bhaveshbanshiwal/Snake_SURGE/3d_parts/3D_motion_parts/snake_head.STEP

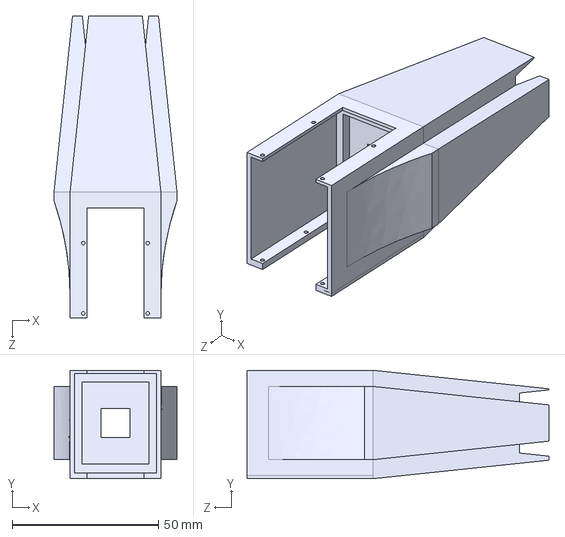
[picture p1: CAD file, 2026-11-07]
3d_parts/3D_motion_parts/snake_head.STEP
42.0 x 37.0 x 103.0 mm
