bhaveshbanshiwal/Snake_SURGE/3d_parts/plate chains/esp_transmittor_case_shell.STEP

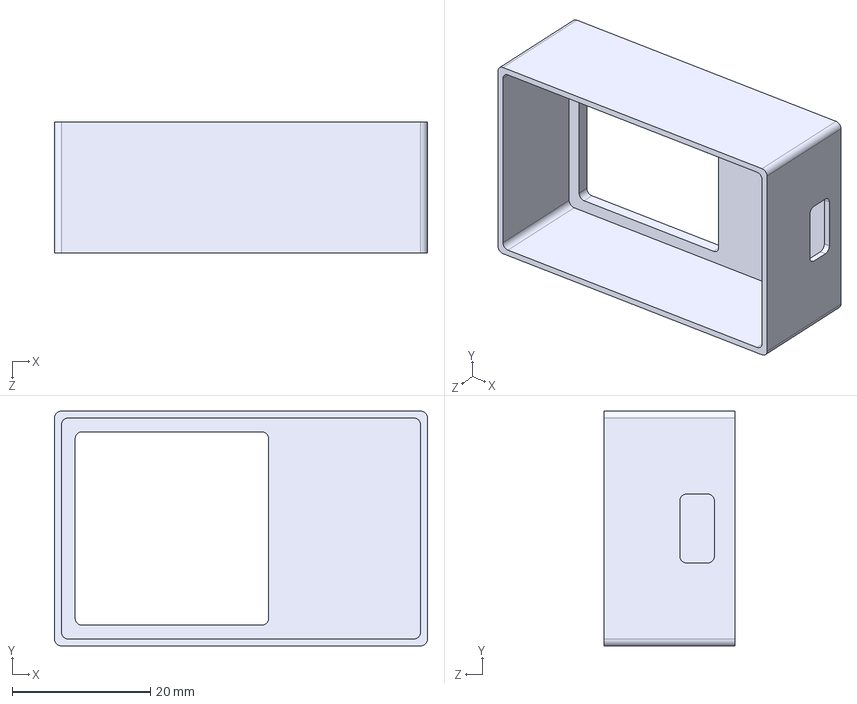
[picture p2: CAD file, 2026-09-26]
3d_parts/plate chains/esp_transmittor_case_shell.STEP
54.0 x 34.0 x 19.0 mm
