bhaveshbanshiwal/Snake_SURGE/3d_parts/3D_motion_parts/battery_middle.STEP

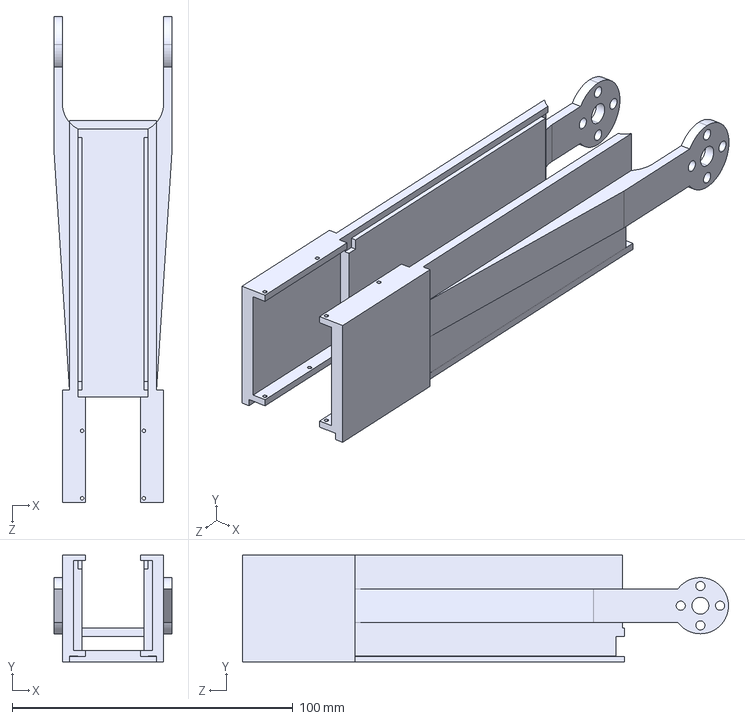
[picture p4: CAD file, 2026-10-31]
3d_parts/3D_motion_parts/battery_middle.STEP
42.0 x 38.0 x 173.0 mm
