bhaveshbanshiwal/Snake_SURGE/3d_parts/plate chains/up_plate_non_power.STEP

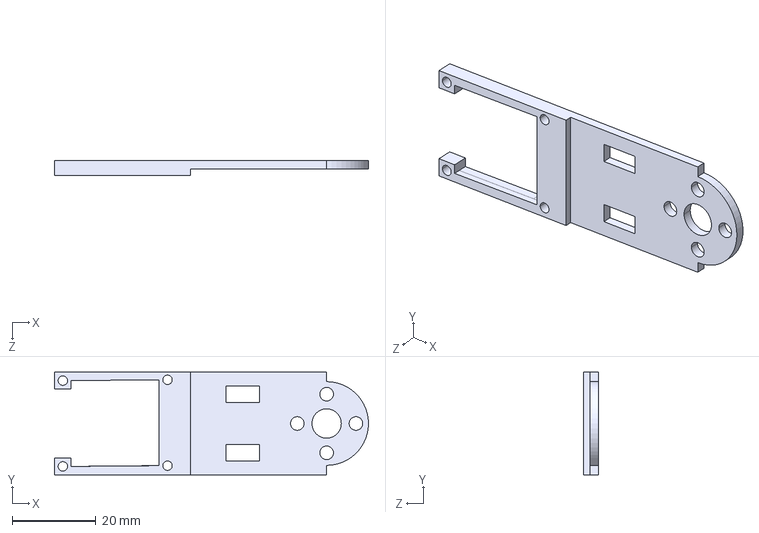
[picture p5: CAD file, 2026-09-26]
3d_parts/plate chains/up_plate_non_power.STEP
75.0 x 24.5 x 3.50 mm
