bhaveshbanshiwal/Snake_SURGE/3d_parts/snake_segment.step

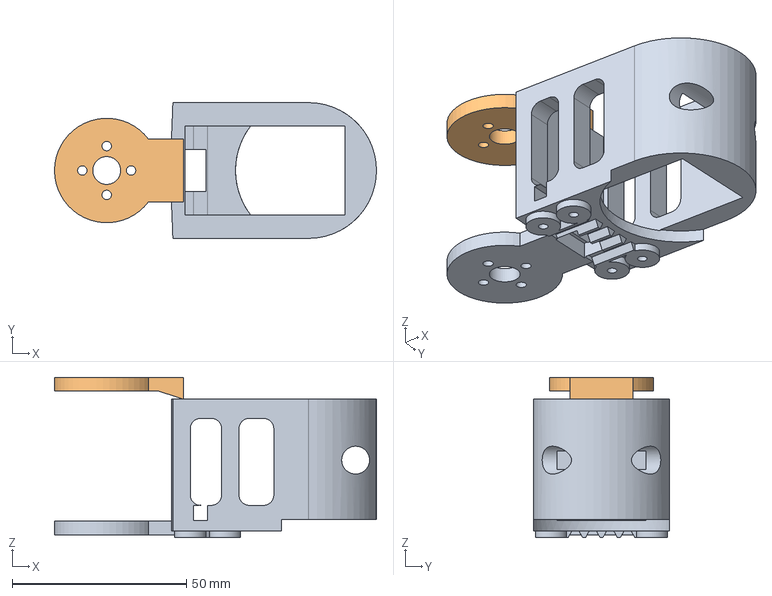
[picture p6: CAD file, 2026-09-23]
3d_parts/snake_segment.step
92.5 x 39.0 x 46.1 mm
