bhaveshbanshiwal/Snake_SURGE/3d_parts/3D_motion_parts/alternate_connector.STEP

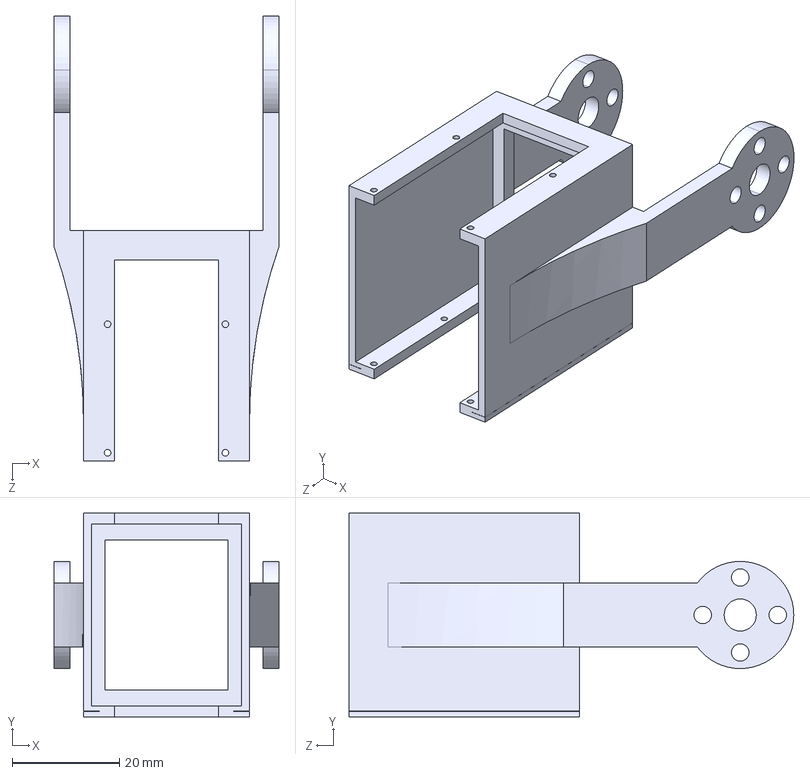
[picture p7: CAD file, 2026-10-31]
3d_parts/3D_motion_parts/alternate_connector.STEP
42.0 x 38.0 x 83.0 mm
