bhaveshbanshiwal/Snake_SURGE/3d_parts/plate chains/esp_transmittor_case.STEP

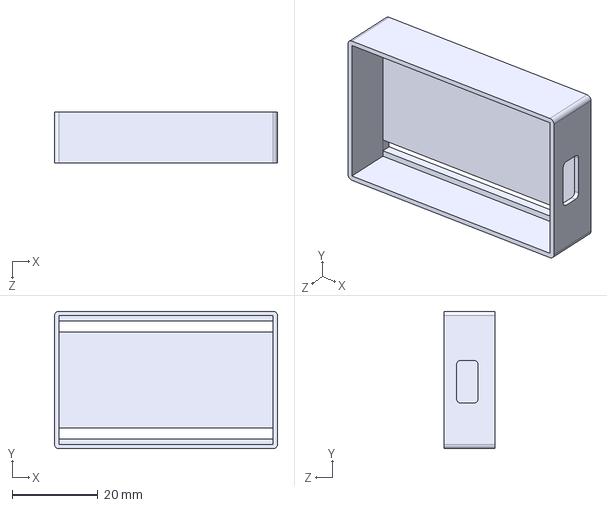
[picture p8: CAD file, 2026-09-26]
3d_parts/plate chains/esp_transmittor_case.STEP
52.0 x 32.0 x 12.0 mm
