bhaveshbanshiwal/Snake_SURGE/3d_parts/plate chains/tail_esp32_waveshare_holder.STEP

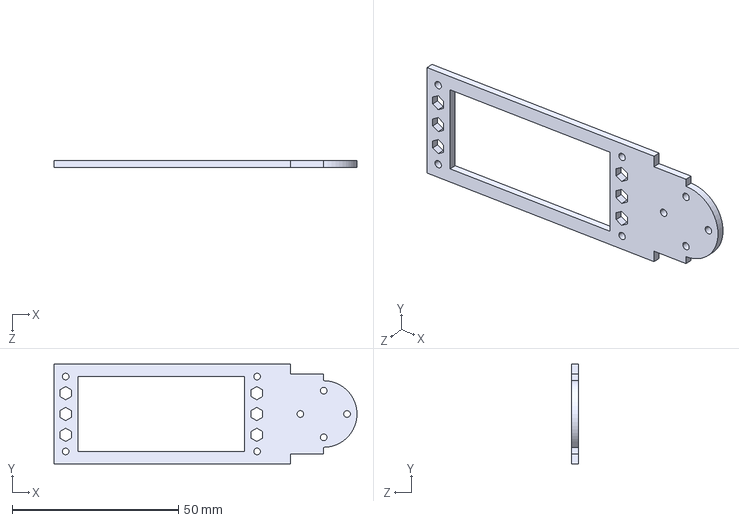
[picture p9: CAD file, 2026-09-25]
3d_parts/plate chains/tail_esp32_waveshare_holder.STEP
91.0 x 30.0 x 2.00 mm
