bhaveshbanshiwal/Snake_SURGE/3d_parts/plate chains/tail_column.STEP

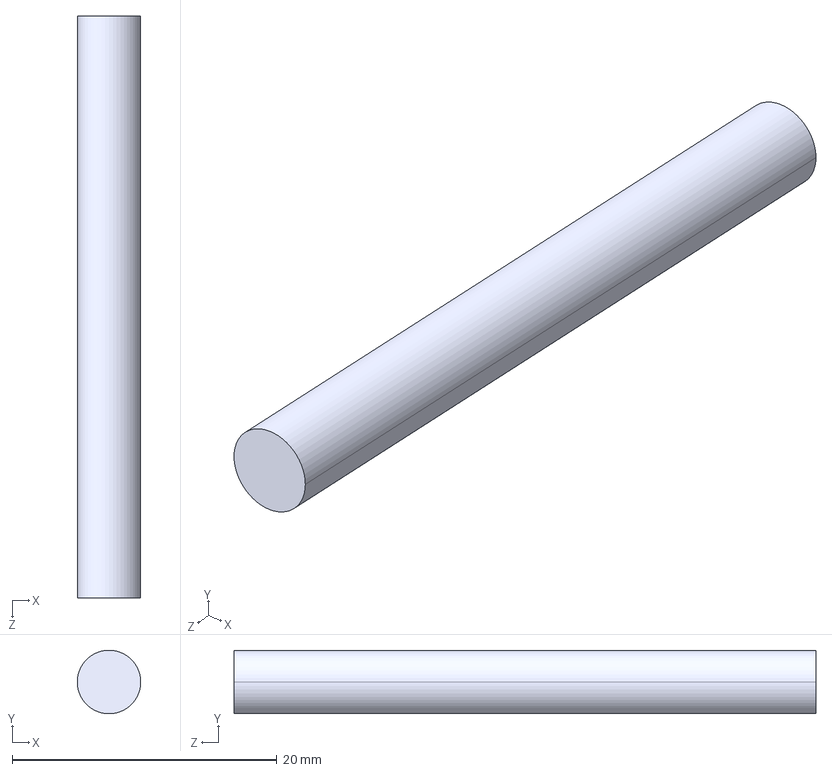
[picture p10: CAD file, 2026-09-25]
3d_parts/plate chains/tail_column.STEP
4.80 x 4.80 x 44.0 mm
