bhaveshbanshiwal/Snake_SURGE/3d_parts/plate chains/waveshare_esp32_holder.STEP

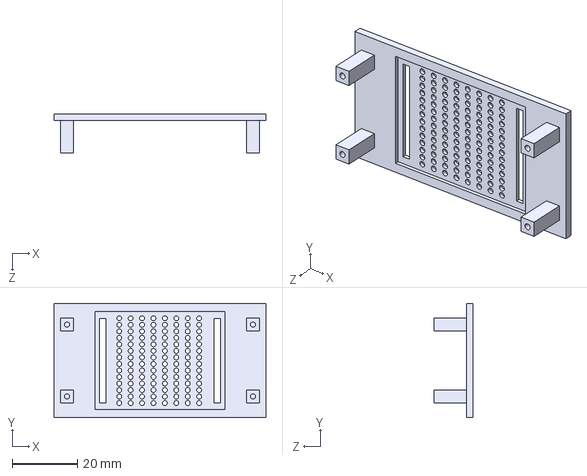
[picture p11: CAD file, 2026-09-24]
3d_parts/plate chains/waveshare_esp32_holder.STEP
65.0 x 35.0 x 12.0 mm
