bhaveshbanshiwal/Snake_SURGE/(list of files, cad)

Other CAD files:
3d_parts/plate chains/down_plate_power.STEP
3d_parts/3D_motion_parts/alternate_connector.SLDPRT
3d_parts/3D_motion_parts/battery_middle.SLDPRT
3d_parts/3D_motion_parts/snake_head.SLDPRT
3d_parts/plate chains/down_plate_power.SLDPRT
3d_parts/plate chains/esp_transmittor_case.SLDPRT
3d_parts/plate chains/esp_transmittor_case_shell.SLDPRT
3d_parts/plate chains/tail_column.SLDPRT
3d_parts/plate chains/tail_esp32_waveshare_holder.SLDPRT
3d_parts/plate chains/up_plate_non_power.SLDPRT
3d_parts/plate chains/waveshare_esp32_holder.SLDPRT
3d_parts/snake_segment.3mf
