bhaveshbanshiwal/Snake_SURGE/adxl_history.txt

commit 35a82d757dcc97c1be2922480adf8482c64d93d7
Author: Bhavesh Banshiwal <97866170+bhaveshbanshiwal@users.noreply.github.com>
Date:   Thu Sep 24 18:27:41 2026 +0530

    new_changes removed the old faulty esp32_st73215.ino file

diff --git a/src/esp32_st3215/esp32_st3215.ino b/src/esp32_st3215/esp32_st3215.ino
index 7fc1bd0..dd99c4a 100644
--- a/src/esp32_st3215/esp32_st3215.ino
+++ b/src/esp32_st3215/esp32_st3215.ino
@@ -1,208 +1,177 @@
+#include "soc/rtc_cntl_reg.h"
+#include "soc/soc.h"
+#include <Adafruit_GFX.h>
+#include <Adafruit_SSD1306.h>
+#include <SCServo.h>
 #include <WiFi.h>
-#include <WebServer.h>
 #include <Wire.h>
-#include <DHT.h>
-#include <Adafruit_Sensor.h>
-#include <Adafruit_BMP280.h>
-#include <Adafruit_ADXL345_U.h>
+#include <esp_mac.h>
+#include <esp_now.h>
 #include <esp_wifi.h>
 
-// --- HOTSPOT SETTINGS ---
-const char* ssid = "NF-07-STATS";
-const char* password = "zaybxc09@";
-
-WebServer server(80); 
-
-// --- PIN MAPPING ---
-const int trigPin = 32; 
-const int echoPin = 34; 
-#define DHTPIN 22     
-#define DHTTYPE DHT11
-DHT dht(DHTPIN, DHTTYPE);
-
-const int I2C_SDA = 21;
-const int I2C_SCL = 19;
-
-Adafruit_BMP280 bmp; 
-Adafruit_ADXL345_Unified accel = Adafruit_ADXL345_Unified(12345);
-
-// --- GLOBAL VARIABLES ---
-float dhtTemp = 0.0, dhtHum = 0.0;
-float bmpTemp = 25.0, bmpPressure = 0.0, bmpAltitude = 0.0;
-float currentDistance = 0.0;
-float accelX = 0.0, accelY = 0.0, accelZ = 0.0;
-
-unsigned long lastFastRead = 0;
-unsigned long lastSlowRead = 0;
-
-// --- PRECISION ULTRASONIC READ ---
-float getAccurateDistance(float tempC) {
-  float soundSpeed_cm_us = (331.3 + 0.606 * tempC) / 10000.0;
-  float samples[3];
-  int validCount = 0;
-
-  for (int i = 0; i < 3; i++) {
-    digitalWrite(trigPin, LOW);
-    delayMicroseconds(2);
-    digitalWrite(trigPin, HIGH);
-    delayMicroseconds(10);
-    digitalWrite(trigPin, LOW);
-    
-    long duration = pulseIn(echoPin, HIGH, 15000); // Tight 15ms timeout to prevent lag
-    if (duration > 0) samples[validCount++] = (duration * soundSpeed_cm_us) / 2.0;
-    delayMicroseconds(500); 
+volatile char wirelessBuffer[250];
+volatile bool hasWirelessCmd = false;
+enum ConnectionState {
+  STATE_INIT,
+  STATE_DISCONNECTED,
+  STATE_USB,
+  STATE_ESPNOW,
+  STATE_BOTH
+};
+ConnectionState currentState = STATE_INIT;
+unsigned long lastUsbTime = 0;
+unsigned long lastEspNowTime = 0;
+unsigned long holdMessageUntil = 0;
+void OnDataRecv(const esp_now_recv_info *info, const uint8_t *incomingData,
+                int len) {
+  if (len < 250) {
+    memcpy((void *)wirelessBuffer, incomingData, len);
+    wirelessBuffer[len] = '\0';
+    hasWirelessCmd = true;
   }
-
-  if (validCount == 0) return 0.0;
-  if (validCount == 1) return samples[0];
-  if (validCount == 2) return (samples[0] + samples[1]) / 2.0;
-
-  if (samples[0] > samples[1]) { float t = samples[0]; samples[0] = samples[1]; samples[1] = t; }
-  if (samples[1] > samples[2]) { float t = samples[1]; samples[1] = samples[2]; samples[2] = t; }
-  if (samples[0] > samples[1]) { float t = samples[0]; samples[0] = samples[1]; samples[1] = t; }
-
-  return samples[1]; 
 }
-
-// --- FRONTEND UI (Chat Removed, 100ms Refresh) ---
-const char INDEX_HTML[] PROGMEM = R"rawliteral(
-<!DOCTYPE html>
-<html>
-<head>
-  <meta name="viewport" content="width=device-width, initial-scale=1">
-  <title>Precision Scale & Sentry</title>
-  <style>
-    body { font-family: Arial, sans-serif; text-align: center; background-color: #121212; color: #ffffff; margin: 0; padding: 20px; }
-    .card { background: #1e1e1e; padding: 20px; margin: 0 auto 20px auto; width: 100%; max-width: 450px; border-radius: 12px; box-shadow: 0 8px 16px rgba(0,0,0,0.6); }
-    h1 { color: #00ffcc; font-size: 22px; margin-bottom: 20px; text-transform: uppercase; letter-spacing: 1px; }
-    h2 { color: #fff; font-size: 15px; margin-bottom: 10px; border-bottom: 1px solid #333; padding-bottom: 5px; text-align: left; text-transform: uppercase; color: #888; margin-top: 25px; }
-    .row { display: flex; justify-content: space-between; align-items: center; padding: 12px 0; border-bottom: 1px solid #2a2a2a; }
-    .row:last-child { border-bottom: none; }
-    .label-group { text-align: left; }
-    .label { font-size: 15px; color: #dddddd; }
-    .sensor { font-size: 11px; color: #777777; margin-left: 5px; }
-    .value { font-size: 18px; font-weight: bold; color: #00ffcc; }
-    .highlight .value { color: #ffd32a; font-size: 24px; }
-  </style>
-</head>
-<body>
-  <div class="card">
-    <h1>Precision Sentry Node</h1>
-    
-    <h2>Live High-Speed Data (100ms)</h2>
-    <div class="row highlight"><div class="label-group"><span class="label">Compensated Distance</span><span class="sensor">(HC-SR04)</span></div><div class="value"><span id="dist">--</span> cm</div></div>
-    <div class="row"><div class="label-group"><span class="label">X-Axis Tilt</span><span class="sensor">(ADXL345)</span></div><div class="value"><span id="tiltX">--</span> g</div></div>
-    <div class="row"><div class="label-group"><span class="label">Y-Axis Tilt</span><span class="sensor">(ADXL345)</span></div><div class="value"><span id="tiltY">--</span> g</div></div>
-    <div class="row"><div class="label-group"><span class="label">Z-Axis Gravity</span><span class="sensor">(ADXL345)</span></div><div class="value"><span id="tiltZ">--</span> g</div></div>
-    
-    <div class="row"><div class="label-group"><span class="label">Micro-Temp</span><span class="sensor">(BMP280)</span></div><div class="value"><span id="bmpT">--</span> &deg;C</div></div>
-    <div class="row"><div class="label-group"><span class="label">Pressure</span><span class="sensor">(BMP280)</span></div><div class="value"><span id="bmpP">--</span> hPa</div></div>
-    <div class="row"><div class="label-group"><span class="label">Altitude</span><span class="sensor">(BMP280)</span></div><div class="value"><span id="bmpA">--</span> m</div></div>
-
-    <h2>Ambient Climate (2000ms)</h2>
-    <div class="row"><div class="label-group"><span class="label">Room Temp</span><span class="sensor">(DHT11)</span></div><div class="value"><span id="dhtT">--</span> &deg;C</div></div>
-    <div class="row"><div class="label-group"><span class="label">Humidity</span><span class="sensor">(DHT11)</span></div><div class="value"><span id="dhtH">--</span> %</div></div>
-  </div>
-
-  <script>
-    // Max-Speed AJAX fetching at 100ms (10 FPS)
-    setInterval(function() {
-      fetch('/data')
-        .then(response => response.json())
-        .then(data => {
-          document.getElementById('dist').innerText = data.dist.toFixed(1);
-          document.getElementById('tiltX').innerText = data.tiltX.toFixed(2);
-          document.getElementById('tiltY').innerText = data.tiltY.toFixed(2);
-          document.getElementById('tiltZ').innerText = data.tiltZ.toFixed(2);
-          
-          document.getElementById('bmpT').innerText = data.bmpT.toFixed(2); // Higher precision for fast updates
-          document.getElementById('bmpP').innerText = data.bmpP.toFixed(1);
-          document.getElementById('bmpA').innerText = data.bmpA.toFixed(0);
-
-          document.getElementById('dhtT').innerText = data.dhtT.toFixed(1);
-          document.getElementById('dhtH').innerText = data.dhtH.toFixed(0);
-        }).catch(err => {});
-    }, 100); 
-  </script>
-</body>
-</html>
-)rawliteral";
-
-void handleRoot() { server.send(200, "text/html", INDEX_HTML); }
-
-void handleData() {
-  String json = "{";
-  json += "\"dist\":" + String(currentDistance, 1) + ",";
-  json += "\"tiltX\":" + String(accelX) + ",";
-  json += "\"tiltY\":" + String(accelY) + ",";
-  json += "\"tiltZ\":" + String(accelZ) + ",";
-  json += "\"bmpT\":" + String(bmpTemp) + ",";
-  json += "\"dhtT\":" + String(dhtTemp) + ",";
-  json += "\"dhtH\":" + String(dhtHum) + ",";
-  json += "\"bmpP\":" + String(bmpPressure) + ",";
-  json += "\"bmpA\":" + String(bmpAltitude);
-  json += "}";
-  server.send(200, "application/json", json);
+#define SCREEN_WIDTH 128
+#define SCREEN_HEIGHT 32
+#define OLED_RESET -1
+Adafruit_SSD1306 display(SCREEN_WIDTH, SCREEN_HEIGHT, &Wire, OLED_RESET);
+void updateDisplay(ConnectionState newState) {
+  if (currentState == newState)
+    return;
+  if (millis() < holdMessageUntil && newState == STATE_DISCONNECTED)
+    return;
+  currentState = newState;
+  display.clearDisplay();
+  display.setTextSize(1);
+  display.setTextColor(SSD1306_WHITE);
+  display.setCursor(0, 0);
+  display.println("Snake SURGE");
+  if (newState == STATE_DISCONNECTED) {
+    display.println("Status: Waiting...");
+    uint8_t mac[6];
+    esp_read_mac(mac, ESP_MAC_WIFI_STA);
+    char macStr[18];
+    snprintf(macStr, sizeof(macStr), "%02X:%02X:%02X:%02X:%02X:%02X", mac[0],
+             mac[1], mac[2], mac[3], mac[4], mac[5]);
+    display.println(macStr);
+  } else if (newState == STATE_USB) {
+    display.println("Status: USB Active");
+  } else if (newState == STATE_ESPNOW) {
+    display.println("Status: Wireless RX");
+  } else if (newState == STATE_BOTH) {
+    display.println("Status: USB+Wireless");
+  }
+  display.display();
 }
-
+SMS_STS st;
+#define S_RXD 18
+#define S_TXD 19
 void setup() {
-  setCpuFrequencyMhz(240); // Max Processor Speed
-
-  pinMode(trigPin, OUTPUT);
-  pinMode(echoPin, INPUT);
-  dht.begin();
-  
-  Wire.begin(I2C_SDA, I2C_SCL); 
-  Wire.setClock(400000); // I2C Fast Mode
-  
-  if (bmp.begin(0x76) || bmp.begin(0x77)) {
-    // Drop standby time to 63ms to allow the BMP280 to update faster than our 100ms loop
-    bmp.setSampling(Adafruit_BMP280::MODE_NORMAL, Adafruit_BMP280::SAMPLING_X2, Adafruit_BMP280::SAMPLING_X16, Adafruit_BMP280::FILTER_X16, Adafruit_BMP280::STANDBY_MS_63);
+  WRITE_PERI_REG(RTC_CNTL_BROWN_OUT_REG, 0);
+  Serial.begin(115200);
+  Serial1.begin(1000000, SERIAL_8N1, S_RXD, S_TXD);
+  st.pSerial = &Serial1;
+  Wire.begin(21, 22);
+  display.begin(SSD1306_SWITCHCAPVCC, 0x3C);
+
+  // SAFETY CAPPING: Limit max torque to 20% (200/1000) for all servos (ID 254)
+  // This physically limits the max current draw so 10 motors won't overload
+  // your supply
+  st.writeWord(254, 48, 200);
+
+  WiFi.mode(WIFI_STA);
+  WiFi.disconnect();
+  esp_wifi_set_channel(1, WIFI_SECOND_CHAN_NONE);
+  updateDisplay(STATE_DISCONNECTED);
+  if (esp_now_init() == ESP_OK) {
+    esp_now_register_recv_cb(OnDataRecv);
+    uint8_t bcast[] = {0xFF, 0xFF, 0xFF, 0xFF, 0xFF, 0xFF};
+    esp_now_peer_info_t peer;
+    memset(&peer, 0, sizeof(peer));
+    memcpy(peer.peer_addr, bcast, 6);
+    peer.channel = 1;
+    peer.encrypt = false;
+    peer.ifidx = WIFI_IF_STA;
+    esp_now_add_peer(&peer);
+  }
+}
+void processCommand(String req) {
+  req.trim();
+  if (req.startsWith("P,")) {
+    String data = req.substring(2);
+    int startIdx = 0;
+    while (startIdx < data.length()) {
+      int commaIdx = data.indexOf(',', startIdx);
+      if (commaIdx == -1)
+        commaIdx = data.length();
+      String pair = data.substring(startIdx, commaIdx);
+      int colonIdx = pair.indexOf(':');
+      if (colonIdx != -1) {
+        int id = pair.substring(0, colonIdx).toInt();
+        int pos = pair.substring(colonIdx + 1).toInt();
+        st.WritePosEx(id, pos, 3400, 50);
+      }
+      startIdx = commaIdx + 1;
+    }
+  } else if (req.startsWith("I,")) {
+    int newId = req.substring(2).toInt();
+    st.unLockEprom(254);
+    st.writeByte(254, 5, newId);
+    st.LockEprom(254);
+    display.clearDisplay();
+    display.setCursor(0, 0);
+    display.println("SUCCESS!");
+    display.println("Servo ID is now: " + String(newId));
+    display.display();
+    holdMessageUntil = millis() + 3000;
+    currentState = STATE_INIT;
+    Serial.println("ID_SET_OK");
+  } else if (req == "T") {
+    String response = "T,";
+    for (int i = 1; i <= 10; i++) {
+      if (st.FeedBack(i) != -1) {
+        int pos = st.ReadPos(-1);
+        int vel = st.ReadSpeed(-1);
+        int load = st.ReadLoad(-1);
+        response += String(i) + ":" + String(load) + ":" + String(vel) + ":" +
+                    String(pos) + ",";
+      }
+    }
+    Serial.println(response);
+    uint8_t bcast[] = {0xFF, 0xFF, 0xFF, 0xFF, 0xFF, 0xFF};
+    esp_now_send(bcast, (uint8_t *)response.c_str(), response.length());
   }
-  if (accel.begin()) accel.setRange(ADXL345_RANGE_16_G);
-  
-  WiFi.softAP(ssid, password); 
-  WiFi.setSleep(false); // No Wi-Fi Sleep
-  esp_wifi_set_ps(WIFI_PS_NONE);
-  WiFi.setTxPower(WIFI_POWER_19_5dBm); // Max Range
-
-  server.on("/", handleRoot);
-  server.on("/data", handleData);
-  server.begin();
 }
-
 void loop() {
-  server.handleClient(); 
-  unsigned long currentMillis = millis();
-
-  // --- MAX SPEED LOOP (100ms) ---
-  if (currentMillis - lastFastRead >= 100) {
-    // 1. Compensated Ultrasonic Read
-    currentDistance = getAccurateDistance(bmpTemp);
-
-    // 2. Accelerometer Read
-    sensors_event_t event; 
-    accel.getEvent(&event);
-    accelX = event.acceleration.x;
-    accelY = event.acceleration.y;
-    accelZ = event.acceleration.z;
-
-    // 3. BMP280 Fast Read (Moved to high-speed loop)
-    bmpTemp = bmp.readTemperature();
-    bmpPressure = bmp.readPressure() / 100.0;
-    bmpAltitude = bmp.readAltitude(1013.25); 
-
-    lastFastRead = currentMillis;
+  unsigned long now = millis();
+  
+  // Auto-reminder: Broadcast 20% torque limit every 5 seconds
+  // This guarantees that if a servo reboots and forgets its RAM limit, it is quickly reminded.
+  static unsigned long lastTorqueReminder = 0;
+  if (now - lastTorqueReminder >= 5000) {
+    lastTorqueReminder = now;
+    st.writeWord(254, 48, 200); 
   }
-
-  // --- HARDWARE LIMITED LOOP (2000ms) ---
-  // DHT11 hardware will lock up and fail if polled faster than 1-2 seconds
-  if (currentMillis - lastSlowRead >= 2000) {
-    float t = dht.readTemperature();
-    float h = dht.readHumidity();
-    if (!isnan(t)) dhtTemp = t;
-    if (!isnan(h)) dhtHum = h;
-
-    lastSlowRead = currentMillis;
+  
+  if (Serial.available()) {
+    String req = Serial.readStringUntil('\n');
+    lastUsbTime = now;
+    processCommand(req);
+  }
+  if (hasWirelessCmd) {
+    String cmd = String((char *)wirelessBuffer);
+    hasWirelessCmd = false;
+    lastEspNowTime = now;
+    processCommand(cmd);
   }
-}
\ No newline at end of file
+  bool currentUsb = (lastUsbTime != 0) && (now - lastUsbTime < 1000);
+  bool currentEspnow = (lastEspNowTime != 0) && (now - lastEspNowTime < 1000);
+  ConnectionState newState = STATE_DISCONNECTED;
+  if (currentUsb && currentEspnow) {
+    newState = STATE_BOTH;
+  } else if (currentUsb) {
+    newState = STATE_USB;
+  } else if (currentEspnow) {
+    newState = STATE_ESPNOW;
+  }
+  updateDisplay(newState);
+}

commit 1e693399ce8ec286fa0c29cdd26e0cc797a923e4
Author: Bhavesh Banshiwal <97866170+bhaveshbanshiwal@users.noreply.github.com>
Date:   Wed Sep 23 22:57:42 2026 +0530

    i think major changes with test

diff --git a/src/esp32_st3215/esp32_st3215.ino b/src/esp32_st3215/esp32_st3215.ino
index 27f77eb..7fc1bd0 100644
--- a/src/esp32_st3215/esp32_st3215.ino
+++ b/src/esp32_st3215/esp32_st3215.ino
@@ -1,236 +1,208 @@
-#include "soc/rtc_cntl_reg.h"
-#include "soc/soc.h"
-#include <Adafruit_GFX.h>
-#include <Adafruit_SSD1306.h>
-#include <Adafruit_NeoPixel.h>
-#include <math.h>
-#include <SCServo.h>
 #include <WiFi.h>
+#include <WebServer.h>
 #include <Wire.h>
-#include <esp_mac.h>
-#include <esp_now.h>
+#include <DHT.h>
+#include <Adafruit_Sensor.h>
+#include <Adafruit_BMP280.h>
+#include <Adafruit_ADXL345_U.h>
 #include <esp_wifi.h>
 
-volatile char wirelessBuffer[250];
-volatile bool hasWirelessCmd = false;
-enum ConnectionState {
-  STATE_INIT,
-  STATE_DISCONNECTED,
-  STATE_USB,
-  STATE_ESPNOW,
-  STATE_BOTH
-};
-ConnectionState currentState = STATE_INIT;
-unsigned long lastUsbTime = 0;
-unsigned long lastEspNowTime = 0;
-unsigned long holdMessageUntil = 0;
-void OnDataRecv(const esp_now_recv_info *info, const uint8_t *incomingData,
-                int len) {
-  if (len < 250) {
-    memcpy((void *)wirelessBuffer, incomingData, len);
-    wirelessBuffer[len] = '\0';
-    hasWirelessCmd = true;
+// --- HOTSPOT SETTINGS ---
+const char* ssid = "NF-07-STATS";
+const char* password = "zaybxc09@";
+
+WebServer server(80); 
+
+// --- PIN MAPPING ---
+const int trigPin = 32; 
+const int echoPin = 34; 
+#define DHTPIN 22     
+#define DHTTYPE DHT11
+DHT dht(DHTPIN, DHTTYPE);
+
+const int I2C_SDA = 21;
+const int I2C_SCL = 19;
+
+Adafruit_BMP280 bmp; 
+Adafruit_ADXL345_Unified accel = Adafruit_ADXL345_Unified(12345);
+
+// --- GLOBAL VARIABLES ---
+float dhtTemp = 0.0, dhtHum = 0.0;
+float bmpTemp = 25.0, bmpPressure = 0.0, bmpAltitude = 0.0;
+float currentDistance = 0.0;
+float accelX = 0.0, accelY = 0.0, accelZ = 0.0;
+
+unsigned long lastFastRead = 0;
+unsigned long lastSlowRead = 0;
+
+// --- PRECISION ULTRASONIC READ ---
+float getAccurateDistance(float tempC) {
+  float soundSpeed_cm_us = (331.3 + 0.606 * tempC) / 10000.0;
+  float samples[3];
+  int validCount = 0;
+
+  for (int i = 0; i < 3; i++) {
+    digitalWrite(trigPin, LOW);
+    delayMicroseconds(2);
+    digitalWrite(trigPin, HIGH);
+    delayMicroseconds(10);
+    digitalWrite(trigPin, LOW);
+    
+    long duration = pulseIn(echoPin, HIGH, 15000); // Tight 15ms timeout to prevent lag
+    if (duration > 0) samples[validCount++] = (duration * soundSpeed_cm_us) / 2.0;
+    delayMicroseconds(500); 
   }
+
+  if (validCount == 0) return 0.0;
+  if (validCount == 1) return samples[0];
+  if (validCount == 2) return (samples[0] + samples[1]) / 2.0;
+
+  if (samples[0] > samples[1]) { float t = samples[0]; samples[0] = samples[1]; samples[1] = t; }
+  if (samples[1] > samples[2]) { float t = samples[1]; samples[1] = samples[2]; samples[2] = t; }
+  if (samples[0] > samples[1]) { float t = samples[0]; samples[0] = samples[1]; samples[1] = t; }
+
+  return samples[1]; 
 }
-#define SCREEN_WIDTH 128
-#define SCREEN_HEIGHT 32
-#define OLED_RESET -1
-Adafruit_SSD1306 display(SCREEN_WIDTH, SCREEN_HEIGHT, &Wire, OLED_RESET);
-
-#define LED_PIN 23
-#define LED_COUNT 2
-Adafruit_NeoPixel strip(LED_COUNT, LED_PIN, NEO_GRB + NEO_KHZ800);
-
-int globalMaxLoad = 0;
-unsigned long lastTelemetryTime = 0;
-bool telemetryActive = false;
-void updateDisplay(ConnectionState newState) {
-  if (currentState == newState)
-    return;
-  if (millis() < holdMessageUntil && newState == STATE_DISCONNECTED)
-    return;
-  currentState = newState;
-  display.clearDisplay();
-  display.setTextSize(1);
-  display.setTextColor(SSD1306_WHITE);
-  display.setCursor(0, 0);
-  display.println("Snake SURGE");
-  if (newState == STATE_DISCONNECTED) {
-    display.println("Status: Waiting...");
-    uint8_t mac[6];
-    esp_read_mac(mac, ESP_MAC_WIFI_STA);
-    char macStr[18];
-    snprintf(macStr, sizeof(macStr), "%02X:%02X:%02X:%02X:%02X:%02X", mac[0],
-             mac[1], mac[2], mac[3], mac[4], mac[5]);
-    display.println(macStr);
-  } else if (newState == STATE_USB) {
-    display.println("Status: USB Active");
-  } else if (newState == STATE_ESPNOW) {
-    display.println("Status: Wireless RX");
-  } else if (newState == STATE_BOTH) {
-    display.println("Status: USB+Wireless");
-  }
-  display.display();
+
+// --- FRONTEND UI (Chat Removed, 100ms Refresh) ---
+const char INDEX_HTML[] PROGMEM = R"rawliteral(
+<!DOCTYPE html>
+<html>
+<head>
+  <meta name="viewport" content="width=device-width, initial-scale=1">
+  <title>Precision Scale & Sentry</title>
+  <style>
+    body { font-family: Arial, sans-serif; text-align: center; background-color: #121212; color: #ffffff; margin: 0; padding: 20px; }
+    .card { background: #1e1e1e; padding: 20px; margin: 0 auto 20px auto; width: 100%; max-width: 450px; border-radius: 12px; box-shadow: 0 8px 16px rgba(0,0,0,0.6); }
+    h1 { color: #00ffcc; font-size: 22px; margin-bottom: 20px; text-transform: uppercase; letter-spacing: 1px; }
+    h2 { color: #fff; font-size: 15px; margin-bottom: 10px; border-bottom: 1px solid #333; padding-bottom: 5px; text-align: left; text-transform: uppercase; color: #888; margin-top: 25px; }
+    .row { display: flex; justify-content: space-between; align-items: center; padding: 12px 0; border-bottom: 1px solid #2a2a2a; }
+    .row:last-child { border-bottom: none; }
+    .label-group { text-align: left; }
+    .label { font-size: 15px; color: #dddddd; }
+    .sensor { font-size: 11px; color: #777777; margin-left: 5px; }
+    .value { font-size: 18px; font-weight: bold; color: #00ffcc; }
+    .highlight .value { color: #ffd32a; font-size: 24px; }
+  </style>
+</head>
+<body>
+  <div class="card">
+    <h1>Precision Sentry Node</h1>
+    
+    <h2>Live High-Speed Data (100ms)</h2>
+    <div class="row highlight"><div class="label-group"><span class="label">Compensated Distance</span><span class="sensor">(HC-SR04)</span></div><div class="value"><span id="dist">--</span> cm</div></div>
+    <div class="row"><div class="label-group"><span class="label">X-Axis Tilt</span><span class="sensor">(ADXL345)</span></div><div class="value"><span id="tiltX">--</span> g</div></div>
+    <div class="row"><div class="label-group"><span class="label">Y-Axis Tilt</span><span class="sensor">(ADXL345)</span></div><div class="value"><span id="tiltY">--</span> g</div></div>
+    <div class="row"><div class="label-group"><span class="label">Z-Axis Gravity</span><span class="sensor">(ADXL345)</span></div><div class="value"><span id="tiltZ">--</span> g</div></div>
+    
+    <div class="row"><div class="label-group"><span class="label">Micro-Temp</span><span class="sensor">(BMP280)</span></div><div class="value"><span id="bmpT">--</span> &deg;C</div></div>
+    <div class="row"><div class="label-group"><span class="label">Pressure</span><span class="sensor">(BMP280)</span></div><div class="value"><span id="bmpP">--</span> hPa</div></div>
+    <div class="row"><div class="label-group"><span class="label">Altitude</span><span class="sensor">(BMP280)</span></div><div class="value"><span id="bmpA">--</span> m</div></div>
+
+    <h2>Ambient Climate (2000ms)</h2>
+    <div class="row"><div class="label-group"><span class="label">Room Temp</span><span class="sensor">(DHT11)</span></div><div class="value"><span id="dhtT">--</span> &deg;C</div></div>
+    <div class="row"><div class="label-group"><span class="label">Humidity</span><span class="sensor">(DHT11)</span></div><div class="value"><span id="dhtH">--</span> %</div></div>
+  </div>
+
+  <script>
+    // Max-Speed AJAX fetching at 100ms (10 FPS)
+    setInterval(function() {
+      fetch('/data')
+        .then(response => response.json())
+        .then(data => {
+          document.getElementById('dist').innerText = data.dist.toFixed(1);
+          document.getElementById('tiltX').innerText = data.tiltX.toFixed(2);
+          document.getElementById('tiltY').innerText = data.tiltY.toFixed(2);
+          document.getElementById('tiltZ').innerText = data.tiltZ.toFixed(2);
+          
+          document.getElementById('bmpT').innerText = data.bmpT.toFixed(2); // Higher precision for fast updates
+          document.getElementById('bmpP').innerText = data.bmpP.toFixed(1);
+          document.getElementById('bmpA').innerText = data.bmpA.toFixed(0);
+
+          document.getElementById('dhtT').innerText = data.dhtT.toFixed(1);
+          document.getElementById('dhtH').innerText = data.dhtH.toFixed(0);
+        }).catch(err => {});
+    }, 100); 
+  </script>
+</body>
+</html>
+)rawliteral";
+
+void handleRoot() { server.send(200, "text/html", INDEX_HTML); }
+
+void handleData() {
+  String json = "{";
+  json += "\"dist\":" + String(currentDistance, 1) + ",";
+  json += "\"tiltX\":" + String(accelX) + ",";
+  json += "\"tiltY\":" + String(accelY) + ",";
+  json += "\"tiltZ\":" + String(accelZ) + ",";
+  json += "\"bmpT\":" + String(bmpTemp) + ",";
+  json += "\"dhtT\":" + String(dhtTemp) + ",";
+  json += "\"dhtH\":" + String(dhtHum) + ",";
+  json += "\"bmpP\":" + String(bmpPressure) + ",";
+  json += "\"bmpA\":" + String(bmpAltitude);
+  json += "}";
+  server.send(200, "application/json", json);
 }
 
-void updateLEDs() {
-  unsigned long now = millis();
-  
-  // LED 0: Connection Status
-  if (currentState == STATE_DISCONNECTED) {
-    // Smooth breathing animation (White)
-    uint8_t breath = (sin(now / 400.0) + 1.0) * 40.0; 
-    strip.setPixelColor(0, strip.Color(breath, breath, breath));
-  } else if (currentState == STATE_USB) {
-    strip.setPixelColor(0, strip.Color(0, 0, 255)); // Blue
-  } else if (currentState == STATE_ESPNOW) {
-    strip.setPixelColor(0, strip.Color(0, 255, 0)); // Green
-  } else if (currentState == STATE_BOTH) {
-    strip.setPixelColor(0, strip.Color(0, 255, 255)); // Cyan
-  }
+void setup() {
+  setCpuFrequencyMhz(240); // Max Processor Speed
 
-  // LED 1: Telemetry & Error Status
-  if (now - lastTelemetryTime > 2000) {
-    telemetryActive = false;
-  }
+  pinMode(trigPin, OUTPUT);
+  pinMode(echoPin, INPUT);
+  dht.begin();
   
-  if (!telemetryActive) {
-    strip.setPixelColor(1, 0); // Off if no telemetry running
-  } else if (globalMaxLoad == -1) {
-    strip.setPixelColor(1, strip.Color(255, 0, 0)); // Hardware Error (No response)
-  } else if (globalMaxLoad > 600) {
-    // Flashing Red Warning for Overload (>60%)
-    if ((now / 150) % 2 == 0) {
-      strip.setPixelColor(1, strip.Color(255, 0, 0));
-    } else {
-      strip.setPixelColor(1, 0);
-    }
-  } else if (globalMaxLoad > 300) {
-    // Solid Yellow (Moderate Load)
-    strip.setPixelColor(1, strip.Color(255, 120, 0));
-  } else {
-    // Solid Green (Normal Safe Load)
-    strip.setPixelColor(1, strip.Color(0, 255, 0));
-  }
+  Wire.begin(I2C_SDA, I2C_SCL); 
+  Wire.setClock(400000); // I2C Fast Mode
   
-  strip.show();
-}
-SMS_STS st;
-#define S_RXD 18
-#define S_TXD 19
-void setup() {
-  WRITE_PERI_REG(RTC_CNTL_BROWN_OUT_REG, 0);
-  Serial.begin(115200);
-  Serial1.begin(1000000, SERIAL_8N1, S_RXD, S_TXD);
-  st.pSerial = &Serial1;
-  Wire.begin(21, 22);
-  display.begin(SSD1306_SWITCHCAPVCC, 0x3C);
-
-  strip.begin();
-  strip.show(); // Initialize all pixels to 'off'
-  strip.setBrightness(50); // Set brightness to 20% (max is 255)
-
-  WiFi.mode(WIFI_STA);
-  WiFi.disconnect();
-  esp_wifi_set_channel(1, WIFI_SECOND_CHAN_NONE);
-  updateDisplay(STATE_DISCONNECTED);
-  if (esp_now_init() == ESP_OK) {
-    esp_now_register_recv_cb(OnDataRecv);
-    uint8_t bcast[] = {0xFF, 0xFF, 0xFF, 0xFF, 0xFF, 0xFF};
-    esp_now_peer_info_t peer;
-    memset(&peer, 0, sizeof(peer));
-    memcpy(peer.peer_addr, bcast, 6);
-    peer.channel = 1;
-    peer.encrypt = false;
-    peer.ifidx = WIFI_IF_STA;
-    esp_now_add_peer(&peer);
-  }
-}
-void processCommand(String req) {
-  req.trim();
-  if (req.startsWith("P,")) {
-    String data = req.substring(2);
-    int startIdx = 0;
-    while (startIdx < data.length()) {
-      int commaIdx = data.indexOf(',', startIdx);
-      if (commaIdx == -1)
-        commaIdx = data.length();
-      String pair = data.substring(startIdx, commaIdx);
-      int colonIdx = pair.indexOf(':');
-      if (colonIdx != -1) {
-        int id = pair.substring(0, colonIdx).toInt();
-        int pos = pair.substring(colonIdx + 1).toInt();
-        st.WritePosEx(id, pos, 3400, 50);
-      }
-      startIdx = commaIdx + 1;
-    }
-  } else if (req.startsWith("I,")) {
-    int newId = req.substring(2).toInt();
-    st.unLockEprom(254);
-    st.writeByte(254, 5, newId);
-    st.LockEprom(254);
-    display.clearDisplay();
-    display.setCursor(0, 0);
-    display.println("SUCCESS!");
-    display.println("Servo ID is now: " + String(newId));
-    display.display();
-    holdMessageUntil = millis() + 3000;
-    currentState = STATE_INIT;
-    Serial.println("ID_SET_OK");
-  } else if (req == "T") {
-    String response = "T,";
-    int currentMaxLoad = -1;
-    int respondedCount = 0;
-    
-    for (int i = 1; i <= 10; i++) {
-      if (st.FeedBack(i) != -1) {
-        respondedCount++;
-        int pos = st.ReadPos(-1);
-        int vel = st.ReadSpeed(-1);
-        int load = st.ReadLoad(-1);
-        if (load > currentMaxLoad) currentMaxLoad = load;
-        
-        response += String(i) + ":" + String(load) + ":" + String(vel) + ":" +
-                    String(pos) + ",";
-      }
-    }
-    
-    if (respondedCount == 0) {
-      globalMaxLoad = -1; // Comms completely dead
-    } else {
-      globalMaxLoad = currentMaxLoad;
-    }
-    lastTelemetryTime = millis();
-    telemetryActive = true;
-    Serial.println(response);
-    uint8_t bcast[] = {0xFF, 0xFF, 0xFF, 0xFF, 0xFF, 0xFF};
-    esp_now_send(bcast, (uint8_t *)response.c_str(), response.length());
+  if (bmp.begin(0x76) || bmp.begin(0x77)) {
+    // Drop standby time to 63ms to allow the BMP280 to update faster than our 100ms loop
+    bmp.setSampling(Adafruit_BMP280::MODE_NORMAL, Adafruit_BMP280::SAMPLING_X2, Adafruit_BMP280::SAMPLING_X16, Adafruit_BMP280::FILTER_X16, Adafruit_BMP280::STANDBY_MS_63);
   }
+  if (accel.begin()) accel.setRange(ADXL345_RANGE_16_G);
+  
+  WiFi.softAP(ssid, password); 
+  WiFi.setSleep(false); // No Wi-Fi Sleep
+  esp_wifi_set_ps(WIFI_PS_NONE);
+  WiFi.setTxPower(WIFI_POWER_19_5dBm); // Max Range
+
+  server.on("/", handleRoot);
+  server.on("/data", handleData);
+  server.begin();
 }
+
 void loop() {
-  unsigned long now = millis();
-  
-  if (Serial.available()) {
-    String req = Serial.readStringUntil('\n');
-    lastUsbTime = now;
-    processCommand(req);
-  }
-  if (hasWirelessCmd) {
-    String cmd = String((char *)wirelessBuffer);
-    hasWirelessCmd = false;
-    lastEspNowTime = now;
-    processCommand(cmd);
+  server.handleClient(); 
+  unsigned long currentMillis = millis();
+
+  // --- MAX SPEED LOOP (100ms) ---
+  if (currentMillis - lastFastRead >= 100) {
+    // 1. Compensated Ultrasonic Read
+    currentDistance = getAccurateDistance(bmpTemp);
+
+    // 2. Accelerometer Read
+    sensors_event_t event; 
+    accel.getEvent(&event);
+    accelX = event.acceleration.x;
+    accelY = event.acceleration.y;
+    accelZ = event.acceleration.z;
+
+    // 3. BMP280 Fast Read (Moved to high-speed loop)
+    bmpTemp = bmp.readTemperature();
+    bmpPressure = bmp.readPressure() / 100.0;
+    bmpAltitude = bmp.readAltitude(1013.25); 
+
+    lastFastRead = currentMillis;
   }
-  bool currentUsb = (lastUsbTime != 0) && (now - lastUsbTime < 1000);
-  bool currentEspnow = (lastEspNowTime != 0) && (now - lastEspNowTime < 1000);
-  ConnectionState newState = STATE_DISCONNECTED;
-  if (currentUsb && currentEspnow) {
-    newState = STATE_BOTH;
-  } else if (currentUsb) {
-    newState = STATE_USB;
-  } else if (currentEspnow) {
-    newState = STATE_ESPNOW;
+
+  // --- HARDWARE LIMITED LOOP (2000ms) ---
+  // DHT11 hardware will lock up and fail if polled faster than 1-2 seconds
+  if (currentMillis - lastSlowRead >= 2000) {
+    float t = dht.readTemperature();
+    float h = dht.readHumidity();
+    if (!isnan(t)) dhtTemp = t;
+    if (!isnan(h)) dhtHum = h;
+
+    lastSlowRead = currentMillis;
   }
-  updateDisplay(newState);
-  updateLEDs();
-}
+}
\ No newline at end of file
