bhaveshbanshiwal/Snake_SURGE/snake.urdf

<?xml version="1.0"?>
<robot name="snake">
  <material name="blue">
    <color rgba="0 0 1 1"/>
  </material>

  <link name="link0">
    <visual>
      <geometry>
        <box size="0.06 0.055 0.055"/>
      </geometry>
      <origin xyz="0.03 0 0"/>
      <material name="blue"/>
    </visual>
    <collision>
      <geometry>
        <box size="0.06 0.055 0.055"/>
      </geometry>
      <origin xyz="0.03 0 0"/>
    </collision>
    <inertial>
      <mass value="0.1"/>
      <origin xyz="0.03 0 0"/>
      <inertia ixx="0.0001" ixy="0" ixz="0" iyy="0.0001" iyz="0" izz="0.0001"/>
    </inertial>
  </link>

  <joint name="joint0" type="revolute">
    <parent link="link0"/>
    <child link="link1"/>
    <origin xyz="0.06 0 0"/>
    <axis xyz="0 0 1"/>
    <limit lower="-1.5" upper="1.5" effort="10" velocity="5"/>
  </joint>

  <link name="link1">
    <visual>
      <geometry>
        <box size="0.06 0.055 0.055"/>
      </geometry>
      <origin xyz="0.03 0 0"/>
      <material name="blue"/>
    </visual>
    <collision>
      <geometry>
        <box size="0.06 0.055 0.055"/>
      </geometry>
      <origin xyz="0.03 0 0"/>
    </collision>
    <inertial>
      <mass value="0.1"/>
      <origin xyz="0.03 0 0"/>
      <inertia ixx="0.0001" ixy="0" ixz="0" iyy="0.0001" iyz="0" izz="0.0001"/>
    </inertial>
  </link>

  <joint name="joint1" type="revolute">
    <parent link="link1"/>
    <child link="link2"/>
    <origin xyz="0.06 0 0"/>
    <axis xyz="0 0 1"/>
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
    </inertial>
  </link>

  <joint name="joint7" type="revolute">
    <parent link="link7"/>
    <child link="link8"/>
    <origin xyz="0.06 0 0"/>
    <axis xyz="0 0 1"/>
    <limit lower="-1.5" upper="1.5" effort="10" velocity="5"/>
  </joint>

  <link name="link8">
    <visual>
      <geometry>
        <box size="0.06 0.055 0.055"/>
      </geometry>
      <origin xyz="0.03 0 0"/>
      <material name="blue"/>
    </visual>
    <collision>
      <geometry>
        <box size="0.06 0.055 0.055"/>
      </geometry>
      <origin xyz="0.03 0 0"/>
    </collision>
    <inertial>
      <mass value="0.1"/>
      <origin xyz="0.03 0 0"/>
      <inertia ixx="0.0001" ixy="0" ixz="0" iyy="0.0001" iyz="0" izz="0.0001"/>
    </inertial>
  </link>

  <joint name="joint8" type="revolute">
    <parent link="link8"/>
    <child link="link9"/>
    <origin xyz="0.06 0 0"/>
    <axis xyz="0 0 1"/>
    <limit lower="-1.5" upper="1.5" effort="10" velocity="5"/>
  </joint>

  <link name="link9">
    <visual>
      <geometry>
        <box size="0.06 0.055 0.055"/>
      </geometry>
      <origin xyz="0.03 0 0"/>
      <material name="blue"/>
    </visual>
    <collision>
      <geometry>
        <box size="0.06 0.055 0.055"/>
      </geometry>
      <origin xyz="0.03 0 0"/>
    </collision>
    <inertial>
      <mass value="0.1"/>
      <origin xyz="0.03 0 0"/>
      <inertia ixx="0.0001" ixy="0" ixz="0" iyy="0.0001" iyz="0" izz="0.0001"/>
    </inertial>
  </link>

</robot>
