bhaveshbanshiwal/Snake_SURGE/(commit log)

2026-06-04 feat: add Bluetooth-controlled starter motor test sketch for ESP32
2026-06-04 Dynamixel , Flow chart
2026-06-08 segment 2
    [assembly.SLDASM, segement2.SLDPRT, segment1.SLDPRT]
2026-06-08 step 3d parts
    [segement2.STEP, segment1.STEP]
2026-06-08 servo 1
2026-06-08 servo 2
2026-06-08 servo v3
2026-06-08 servo 4
2026-06-08 servo 5
2026-06-08 refactor: loop servo movement indefinitely and reduce delay interval to 0.5 seconds
2026-06-23 simulation using pybullet added
    [snake.urdf]
2026-06-29 switched from gui to webui
2026-06-29 Add steady camera tracking and infinite grid to 3D viewer
2026-06-29 Add guide for LLM Autonomy Setup on Raspberry Pi 5
2026-09-04 20% max load , 510mA Limiter 6kgcm
2026-09-04 telemetry for RGB LEDs on wavashare board
2026-09-23 i think major changes with test
    [ST3215.step, XL,XC-330.stp, assembly.SLDASM, segement2.SLDPRT, segement2.STEP, segement2_v1.STL, segment1.SLDPRT, segment1.STEP]
2026-09-24 new_changes removed the old faulty esp32_st73215.ino file
2026-09-24 faulty codes fixed with an center aligner
    [down_plate_power.SLDPRT, down_plate_power.STEP, up_plate_non_power.SLDPRT, up_plate_non_power.STEP]
2026-09-24 parts updated
    [up_plate_non_power.SLDPRT, up_plate_non_power.STEP, waveshare_esp32_holder.SLDPRT, waveshare_esp32_holder.STEP]
2026-09-25 offset_correction_build plates
    [up_plate_non_power.SLDPRT, up_plate_non_power.STEP]
2026-10-04 sensory esp32 code added and reciever waveshare esp32 shorted and need a replacement
2026-10-09 replacing esp32 waveshare driver
2026-11-07 fix(ui): enable CONNECT SIMULATION ENGINE button without prior operator login check in JS
